hasanyucelcogal/BC95-NB-IOT-CE/README.md

# BC95-NB-IOT-CE

Quectel BC95 NB IOT IO Module. Assembled fully by hand.
