hasanyucelcogal/BC95-NB-IOT-CE/BC95_NB-IOT.kicad_pcb

## KiCad design BC95_NB-IOT.kicad_pcb (2023-03-18)

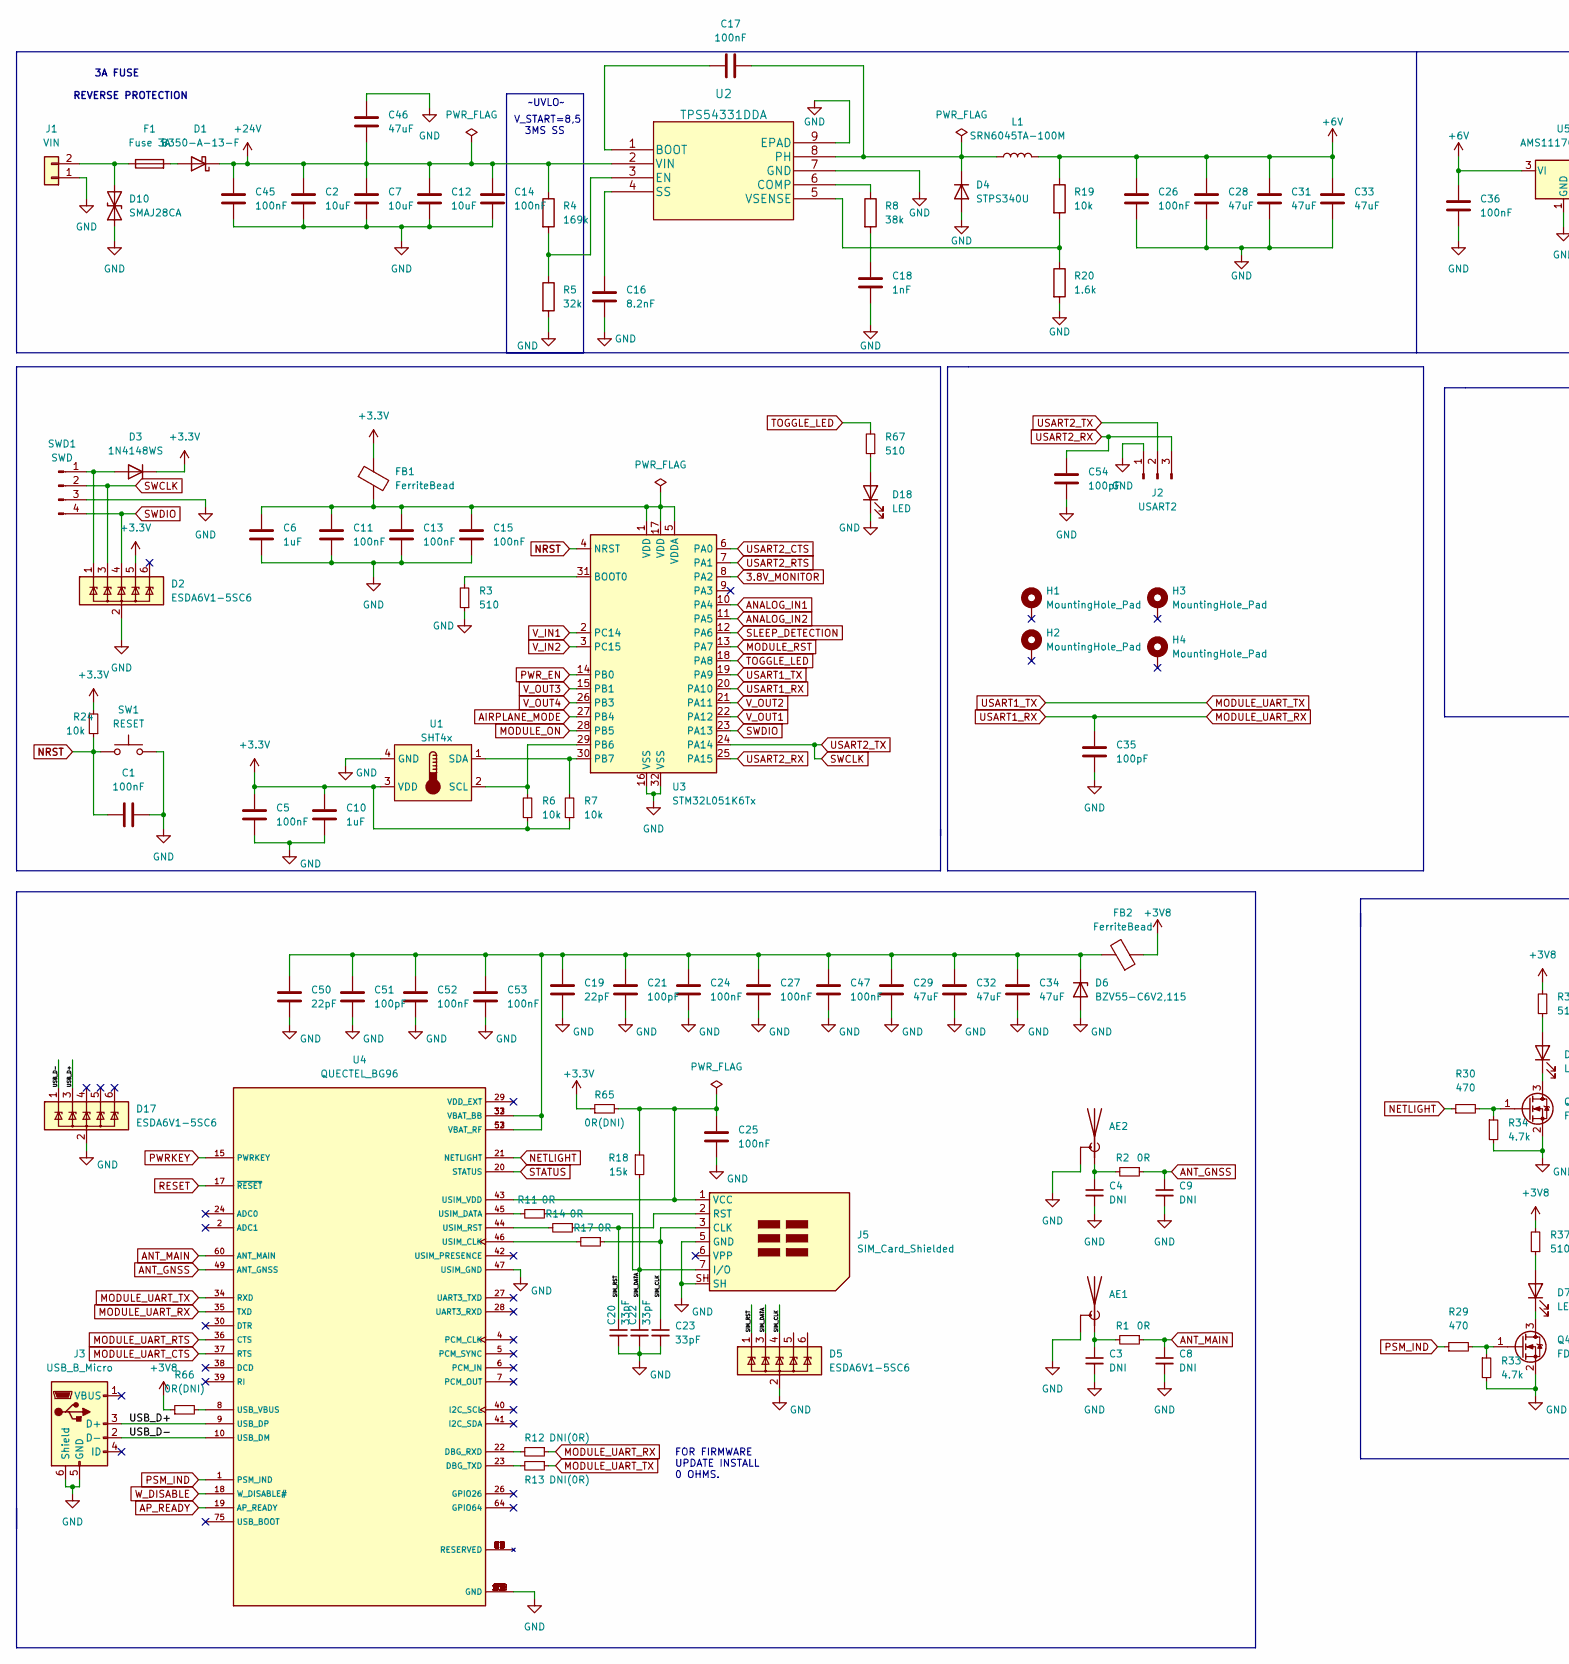
[picture p1: schematic BC95_NB-IOT.kicad_sch, BC95_NB-IOT_MODULE, part in row 1, column 1]

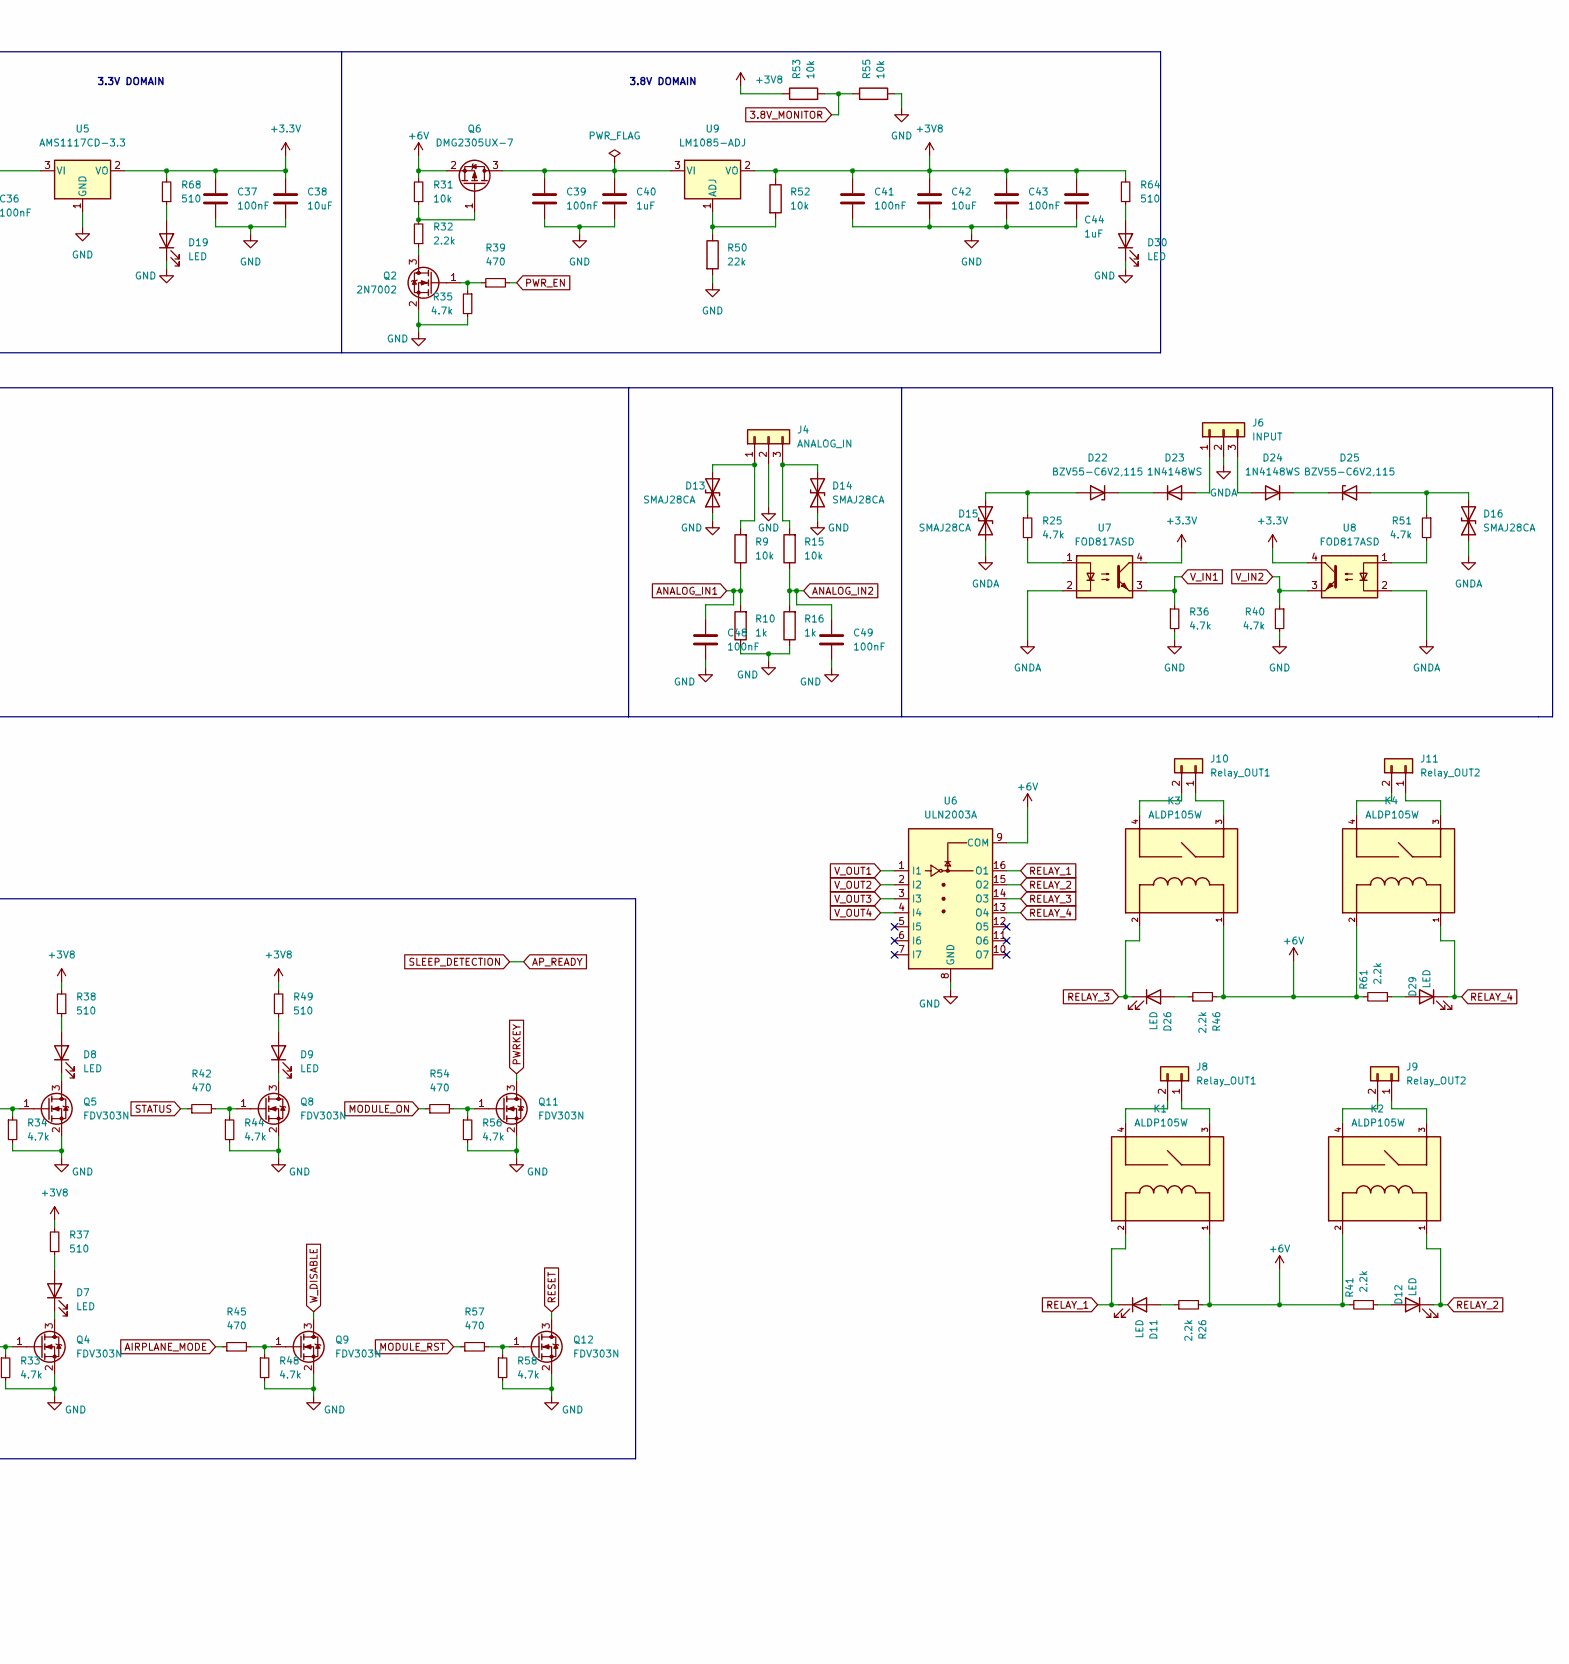
[picture p2: schematic BC95_NB-IOT.kicad_sch, BC95_NB-IOT_MODULE, part in row 1, column 2]

Parts:
AE1, AE2: SMA_Amphenol_132134-10_Vertical
C1, C5, C11, C13, C14, C15, C17, C24, C25, C26, C27, C36, C37, C39, C41, C43, C45, C47, C48, C49, C52, C53: 100nF; C_0603_1608Metric
C2, C7, C12: 10uF; C_1206_3216Metric
C3, C4, C8, C9: DNI; C_0603_1608Metric
C6, C10, C40, C44: 1uF; C_0603_1608Metric
C16: 8.2nF; C_0603_1608Metric
C18: 1nF; C_0603_1608Metric
C19, C50: 22pF; C_0603_1608Metric
C20, C22, C23: 33pF; C_0603_1608Metric
C21, C35, C51, C54: 100pF; C_0603_1608Metric
C28, C29, C31, C32, C33, C34: 47uF; CP_EIA-3528-21_Kemet-B
C38, C42: 10uF; CP_EIA-3528-21_Kemet-B
C46: 47uF; C_1206_3216Metric_Pad1.33x1.80mm_HandSolder
D1: B350-A-13-F; D_SMA
D2, D5, D17: ESDA6V1-5SC6; SOT-23-6
D3, D23, D24: 1N4148WS; D_SOD-323
D4: STPS340U; D_SMB
D6, D22, D25: BZV55-C6V2,115; D_MiniMELF
D7, D8, D9, D11, D12, D18, D19, D26, D29, D30: LED; LED_0603_1608Metric
D10, D13, D14, D15, D16: SMAJ28CA; D_SMA
F1: Fuse 3A; Fuse_Littelfuse-NANO2-451_453
FB1, FB2: FerriteBead; R_0603_1608Metric
H1, H2, H3, H4: MountingHole_Pad; MountingHole_3.2mm_M3_Pad
J1: VIN; TerminalBlock_Phoenix_MKDS-1,5-2-5.08_1x02_P5.08mm_Horizont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
J2: USART2; PinHeader_1x03_P2.54mm_Vertical
J3: USB_B_Micro; USB_Micro-B_Molex_47346-0001
J4: ANALOG_IN; PhoenixContact_MC_1,5_3-G-3.81_1x03_P3.81mm_Horizontal
J5: SIM_Card_Shielded; ATTEND_MICRO_SIM
J6: INPUT; PhoenixContact_MC_1,5_3-G-3.81_1x03_P3.81mm_Horizontal
J8, J10: Relay_OUT1; PhoenixContact_MC_1,5_2-G-5.08_1x02_P5.08mm_Horizontal
J9, J11: Relay_OUT2; PhoenixContact_MC_1,5_2-G-5.08_1x02_P5.08mm_Horizontal
K1, K2, K3, K4: ALDP105W; RELAY_ALDP105W; PARTREV N/A
L1: SRN6045TA-100M; L_Bourns_SRN6045TA
Q2: 2N7002; SOT-23
Q4, Q5, Q8, Q9, Q11, Q12: FDV303N; SOT-23
Q6: DMG2305UX-7; SOT-23
R1, R2, R11, R14, R17: 0R; R_0603_1608Metric
R3, R37, R38, R49, R64, R67, R68: 510; R_0603_1608Metric
R4: 169k; R_0603_1608Metric
R5: 32k; R_0603_1608Metric
R6, R7, R9, R15, R19, R24, R31, R52, R53, R55: 10k; R_0603_1608Metric
R8: 38k; R_0603_1608Metric
R10, R16: 1k; R_0603_1608Metric
R12, R13: DNI(0R); R_0603_1608Metric
R18: 15k; R_0603_1608Metric
R20: 1.6k; R_0603_1608Metric
R25, R33, R34, R35, R36, R40, R44, R48, R51, R56, R58: 4.7k; R_0603_1608Metric
R26, R32, R41, R46, R61: 2.2k; R_0603_1608Metric
R29, R30, R39, R42, R45, R54, R57: 470; R_0603_1608Metric
R50: 22k; R_0603_1608Metric
R65, R66: 0R(DNI); R_0603_1608Metric
SW1: RESET; SW_SPST_B3U-1000P
SWD1: SWD; PinHeader_1x04_P2.54mm_Vertical
U1: SHT4x; SHT4X
U2: TPS54331DDA; TI_SO-PowerPAD-8_ThermalVias
U3: STM32L051K6Tx; LQFP-32_7x7mm_P0.8mm
U4: QUECTEL_BG96; XCVR_BG96
U5: AMS1117CD-3.3; TO-252-3_TabPin2
U6: ULN2003A; SSOP-16_3.9x4.9mm_P0.635mm
U7, U8: FOD817ASD; SMDIP-4_W9.53mm
U9: LM1085-ADJ; TO-263-3_TabPin2

Connections:
3.8V_MONITOR: R53.2, R55.1, U3.8 (PA2)
+3V3: C5.1, C10.1, C37.1, C38.1, D2.5 (IO4), D3.1 (K), FB1.1, R6.1, R7.1, R24.2, R65.1, R68.2, U1.3 (VDD), U5.2 (VO), U7.4, U8.4
+3V8: C41.1, C42.1, C43.1, C44.1, FB2.1, R37.2, R38.2, R49.2, R52.1, R53.1, R64.2, R66.1, U9.2 (VO)
+6V: C26.2, C28.1, C31.1, C33.1, C36.1, K1.1, K2.2, K3.1, K4.2, L1.2, Q6.2 (S), R19.1, R26.2, R31.2, R41.2, R46.2, R61.2, U5.3 (VI), U6.9 (COM)
+24V: C2.1, C7.1, C12.1, C14.2, C45.2, C46.1, D1.1 (K), R4.1, U2.2 (VIN)
/SIM_CLK: C23.1, D5.4 (IO3), J5.3 (CLK), R17.1
/SIM_DATA: C22.1, D5.3 (IO2), J5.7 (I/O), R11.1, R18.2
/SIM_RST: C20.1, D5.1 (IO1), J5.2 (RST), R14.1
/USB_D+: D17.3 (IO2), J3.3 (D+), U4.9 (USB_DP)
/USB_D-: D17.1 (IO1), J3.2 (D-), U4.10 (USB_DM)
AIRPLANE_MODE: R45.1, U3.27 (PB4)
ANALOG_IN1: C48.1, R9.1, R10.2, U3.10 (PA4)
ANALOG_IN2: C49.1, R15.1, R16.2, U3.11 (PA5)
ANT_GNSS: C9.1, R2.1, U4.49 (ANT_GNSS)
ANT_MAIN: C8.1, R1.1, U4.60 (ANT_MAIN)
AP_READY: U3.12 (PA6), U4.19 (AP_READY)
GND: AE1.2 (Shield), AE2.2 (Shield), C1.2, C2.2, C3.2, C4.2, C5.2, C6.2, C7.2, C8.2, C9.2, C10.2, C11.2, C12.2, C13.2, C14.1, C15.2, C16.1, C18.1, C19.2, C20.2, C21.2, C22.2, C23.2, C24.2, C25.2, C26.1, C27.2, C28.2, C29.2, C31.2, C32.2, C33.2, C34.2, C35.2, C36.2, C37.2, C38.2, C39.2, C40.2, C41.2, C42.2, C43.2, C44.2, C45.1, C46.2, C47.2, C48.2, C49.2, C50.2, C51.2, C52.2, C53.2, C54.2, D2.2 (GND), D4.2 (A), D5.2 (GND), D6.2 (A), D10.1 (A1), D13.1 (A1), D14.1 (A1), D17.2 (GND), D18.1 (K), D19.1 (K), D30.1 (K), J1.1, J2.1, J3.5 (GND), J3.6 (Shield), J4.2, J5.5 (GND), J5.SH, Q2.2 (S), Q4.2 (S), Q5.2 (S), Q8.2 (S), Q9.2 (S), Q11.2 (S), Q12.2 (S), R3.1, R5.2, R10.1, R16.1, R20.2, R33.2, R34.2, R35.2, R36.2, R40.2, R44.2, R48.2, R50.2, R55.2, R56.2, R58.2, SW1.2, SWD1.3, U1.4 (GND), U2.7 (GND), U2.9 (EPAD), U3.16 (VSS), U3.32 (VSS), U4.3 (GND), U4.31 (GND), U4.47 (USIM_GND), U4.48 (GND), U4.50 (GND), U4.54 (GND), U4.55 (GND), U4.58 (GND), U4.59 (GND), U4.61 (GND), U4.62 (GND), U4.67 (GND), U4.68 (GND), U4.69 (GND), U4.70 (GND), U4.71 (GND), U4.72 (GND), U4.73 (GND), U4.74 (GND), U4.79 (GND), U4.80 (GND), U4.81 (GND), U4.82 (GND), U4.89 (GND), U4.90 (GND), U4.91 (GND), U4.100 (GND), U4.101 (GND), U4.102 (GND), U5.1 (GND), U6.8 (GND)
GNDA: D15.1 (A1), D16.1 (A1), J6.2, U7.2, U8.2
MODULE_ON: R54.1, U3.28 (PB5)
MODULE_RST: R57.1, U3.13 (PA7)
MODULE_UART_CTS: U4.37 (RTS)
MODULE_UART_RTS: U4.36 (CTS)
MODULE_UART_RX: C35.1, R12.1, U3.20 (PA10), U4.35 (TXD)
MODULE_UART_TX: R13.1, U3.19 (PA9), U4.34 (RXD)
NETLIGHT: R30.1, U4.21 (NETLIGHT)
NRST: C1.1, R24.1, SW1.1, U3.4 (NRST)
unnamed: AE1.1 (A), C3.1, R1.2
unnamed: AE2.1 (A), C4.1, R2.2
unnamed: C6.1, C11.1, C13.1, C15.1, FB1.2, U3.1 (VDD), U3.5 (VDDA), U3.17 (VDD)
unnamed: C16.2, U2.4 (SS)
unnamed: C17.1, U2.1 (BOOT)
unnamed: C17.2, D4.1 (K), L1.1, U2.8 (PH)
unnamed: C18.2, R8.2
unnamed: C19.1, C21.1, C24.1, C27.1, C29.1, C32.1, C34.1, C47.1, C50.1, C51.1, C52.1, C53.1, D6.1 (K), FB2.2, U4.32 (VBAT_BB), U4.33 (VBAT_BB), U4.52 (VBAT_RF), U4.53 (VBAT_RF)
unnamed: C25.1, J5.1 (VCC), R18.1, R65.2, U4.43 (USIM_VDD)
unnamed: C39.1, C40.1, Q6.3 (D), U9.3 (VI)
unnamed: D1.2 (A), F1.2
unnamed: D2.1 (IO1), D3.2 (A), SWD1.1
unnamed: D7.1 (K), Q4.3 (D)
unnamed: D7.2 (A), R37.1
unnamed: D8.1 (K), Q5.3 (D)
unnamed: D8.2 (A), R38.1
unnamed: D9.1 (K), Q8.3 (D)
unnamed: D9.2 (A), R49.1
unnamed: D10.2 (A2), F1.1, J1.2
unnamed: D11.2 (A), R26.1
unnamed: D12.2 (A), R41.1
unnamed: D13.2 (A2), J4.1, R9.2
unnamed: D14.2 (A2), J4.3, R15.2
unnamed: D15.2 (A2), D22.2 (A), R25.1
unnamed: D16.2 (A2), D25.2 (A), R51.1
unnamed: D18.2 (A), R67.1
unnamed: D19.2 (A), R68.1
unnamed: D22.1 (K), D23.1 (K)
unnamed: D23.2 (A), J6.1
unnamed: D24.1 (K), D25.1 (K)
unnamed: D24.2 (A), J6.3
unnamed: D26.2 (A), R46.1
unnamed: D29.2 (A), R61.1
unnamed: D30.2 (A), R64.1
unnamed: J8.1, K1.3
unnamed: J8.2, K1.4
unnamed: J9.1, K2.3
unnamed: J9.2, K2.4
unnamed: J10.1, K3.3
unnamed: J10.2, K3.4
unnamed: J11.1, K4.3
unnamed: J11.2, K4.4
unnamed: Q2.1 (G), R35.1, R39.1
unnamed: Q2.3 (D), R32.1
unnamed: Q4.1 (G), R29.2, R33.1
unnamed: Q5.1 (G), R30.2, R34.1
unnamed: Q6.1 (G), R31.1, R32.2
unnamed: Q8.1 (G), R42.2, R44.1
unnamed: Q9.1 (G), R45.2, R48.1
unnamed: Q11.1 (G), R54.2, R56.1
unnamed: Q12.1 (G), R57.2, R58.1
unnamed: R3.2, U3.31 (BOOT0)
unnamed: R4.2, R5.1, U2.3 (EN)
unnamed: R6.2, U1.2 (SCL), U3.29 (PB6)
unnamed: R7.2, U1.1 (SDA), U3.30 (PB7)
unnamed: R8.1, U2.6 (COMP)
unnamed: R11.2, U4.45 (USIM_DATA)
unnamed: R12.2, U4.22 (DBG_RXD)
unnamed: R13.2, U4.23 (DBG_TXD)
unnamed: R14.2, U4.44 (USIM_RST)
unnamed: R17.2, U4.46 (USIM_CLK)
unnamed: R19.2, R20.1, U2.5 (VSENSE)
unnamed: R25.2, U7.1
unnamed: R50.1, R52.2, U9.1 (ADJ)
unnamed: R51.2, U8.1
unnamed: R66.2, U4.8 (USB_VBUS)
PSM_IND: R29.1, U4.1 (PSM_IND)
PWRKEY: Q11.3 (D), U4.15 (PWRKEY)
PWR_EN: R39.2, U3.14 (PB0)
RELAY_1: D11.1 (K), K1.2, U6.16 (O1)
RELAY_2: D12.1 (K), K2.1, U6.15 (O2)
RELAY_3: D26.1 (K), K3.2, U6.14 (O3)
RELAY_4: D29.1 (K), K4.1, U6.13 (O4)
RESET: Q12.3 (D), U4.17 (~RESET)
STATUS: R42.1, U4.20 (STATUS)
SWCLK: D2.3 (IO2), J2.2, SWD1.2, U3.24 (PA14)
SWDIO: D2.4 (IO3), SWD1.4, U3.23 (PA13)
TOGGLE_LED: R67.2, U3.18 (PA8)
USART2_CTS: U3.6 (PA0)
USART2_RTS: U3.7 (PA1)
USART2_RX: C54.1, J2.3, U3.25 (PA15)
V_IN1: R36.1, U3.2 (PC14), U7.3
V_IN2: R40.1, U3.3 (PC15), U8.3
V_OUT1: U3.22 (PA12), U6.1 (I1)
V_OUT2: U3.21 (PA11), U6.2 (I2)
V_OUT3: U3.15 (PB1), U6.3 (I3)
V_OUT4: U3.26 (PB3), U6.4 (I4)
W_DISABLE: Q9.3 (D), U4.18 (W_DISABLE#)

Notes on the sheet:
FOR FIRMWARE UPDATE INSTALL 0 OHMS.
V_START=8,5 3MS SS
~UVLO~
3.3V DOMAIN
3A FUSE REVERSE PROTECTION
3.8V DOMAIN

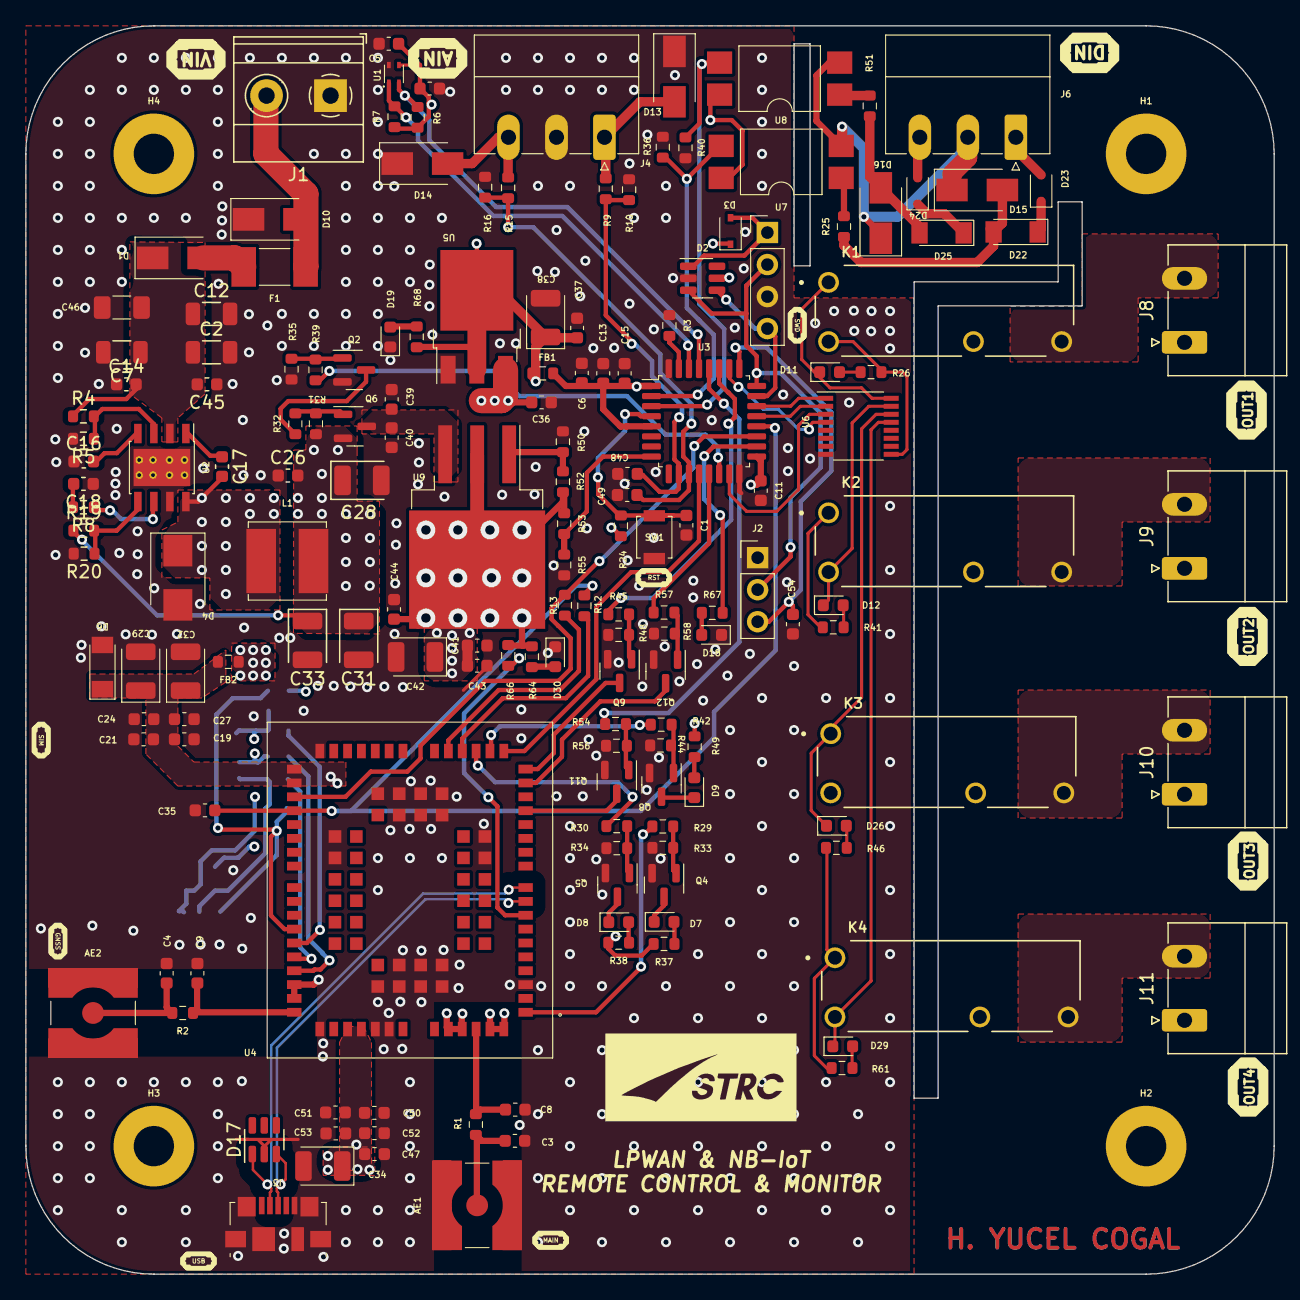
[picture p3: board BC95_NB-IOT.kicad_pcb from above]

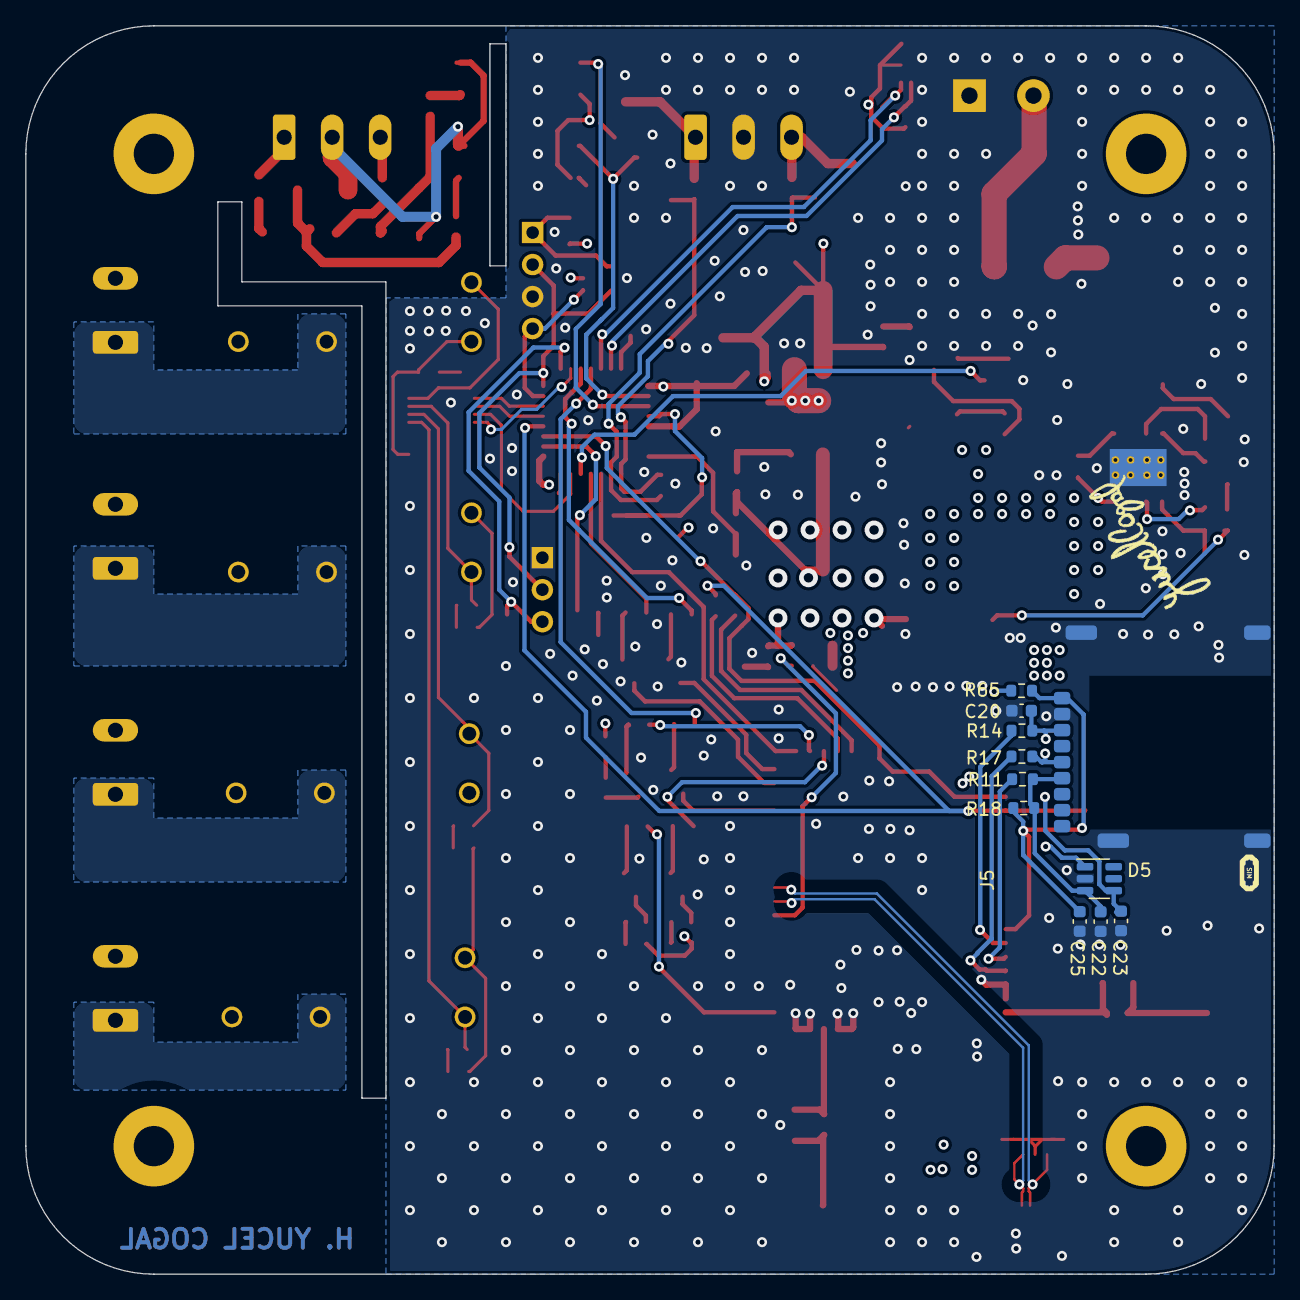
[picture p4: board BC95_NB-IOT.kicad_pcb from below]

Board: 4 copper layers, 99.1 x 99.1 mm, 179 parts (11 on the bottom side), 110 nets.
