hasanyucelcogal/BC95-NB-IOT-CE/(commit log)

2023-02-16 bom update
    [BC95_NB-IOT.kicad_pcb, BC95_NB-IOT.kicad_sch]
2023-02-16 gerber generating
